marcutudor79/embedded-intrusion-system-ETTI-pr2/Docs/PINOUT.jpeg

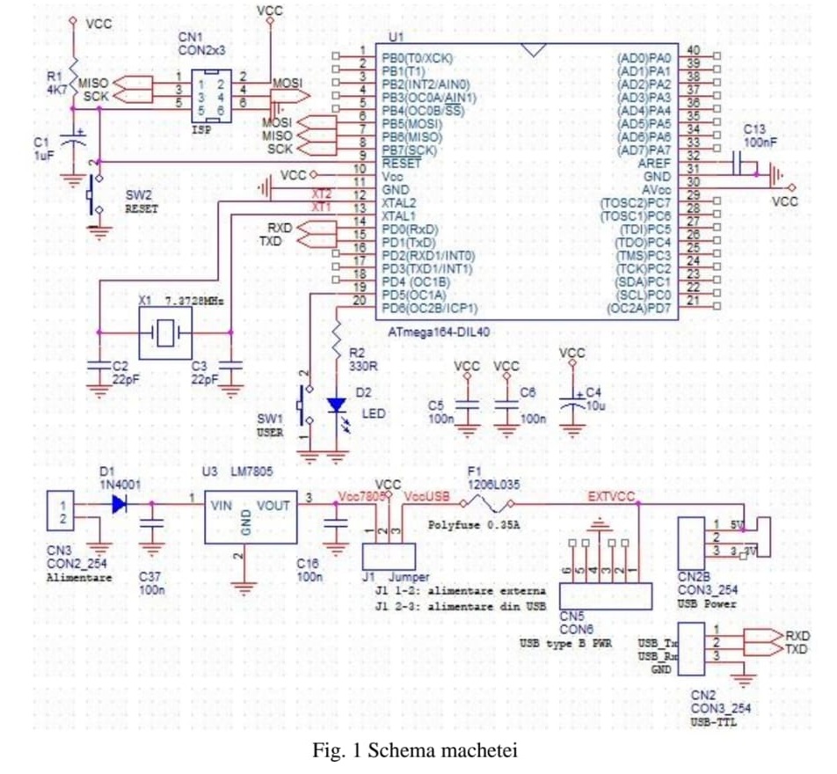
Docs/PINOUT.jpeg
