marcutudor79/embedded-intrusion-system-ETTI-pr2/Docs/Pictures/WhatsApp Image 2023-03-14 at 20.57.14.jpg

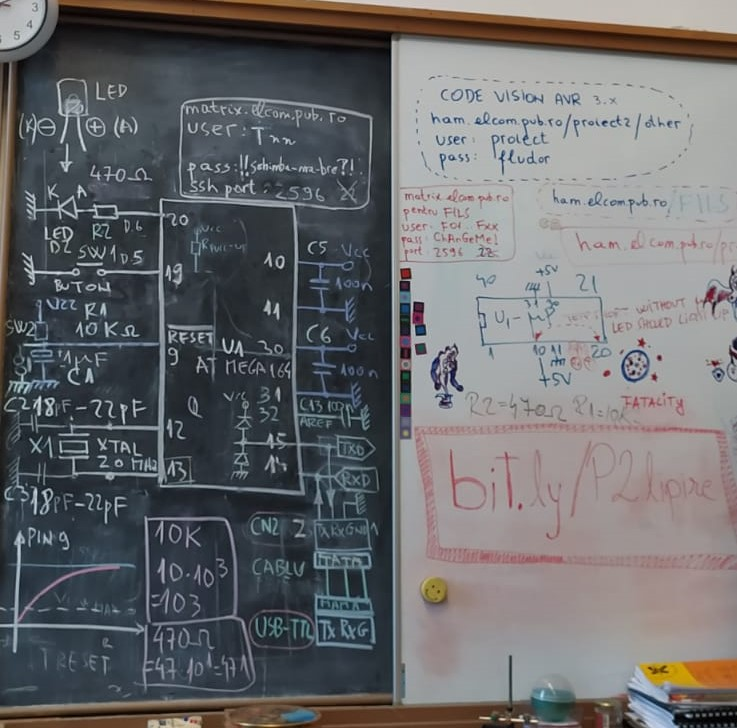
Docs/Pictures/WhatsApp Image 2023-03-14 at 20.57.14.jpg
