marcutudor79/embedded-intrusion-system-ETTI-pr2/Docs/Ordinea recomandata a lipirii pieselor pe placa P2.pdf

Proiect2

## Ordinea recomandata a lipirii pieselor pe placa etti

Se lipesc piese doar pe fateta cu silkscreen (stratul scris cu alb).

Lipim piesele de inaltime redusa mai intai si apoi pe cele de inaltime mai mare.

Pentru componentele SMD se aplica putin fludor pe cele 2 pad-uri, ulterior se prinde cu o penseta si se lipeste la un capat, pe urma la celalalt.

Informatii suplimentare pe site-ul ham (http://ham.elcom.pub.ro/proiect2/doc.htm) (aici (http://ham.elcom.pub.ro/proiect2/solder.htm) si aici). (https://www.youtube.com/watch?v=oqV2xU1fee8)

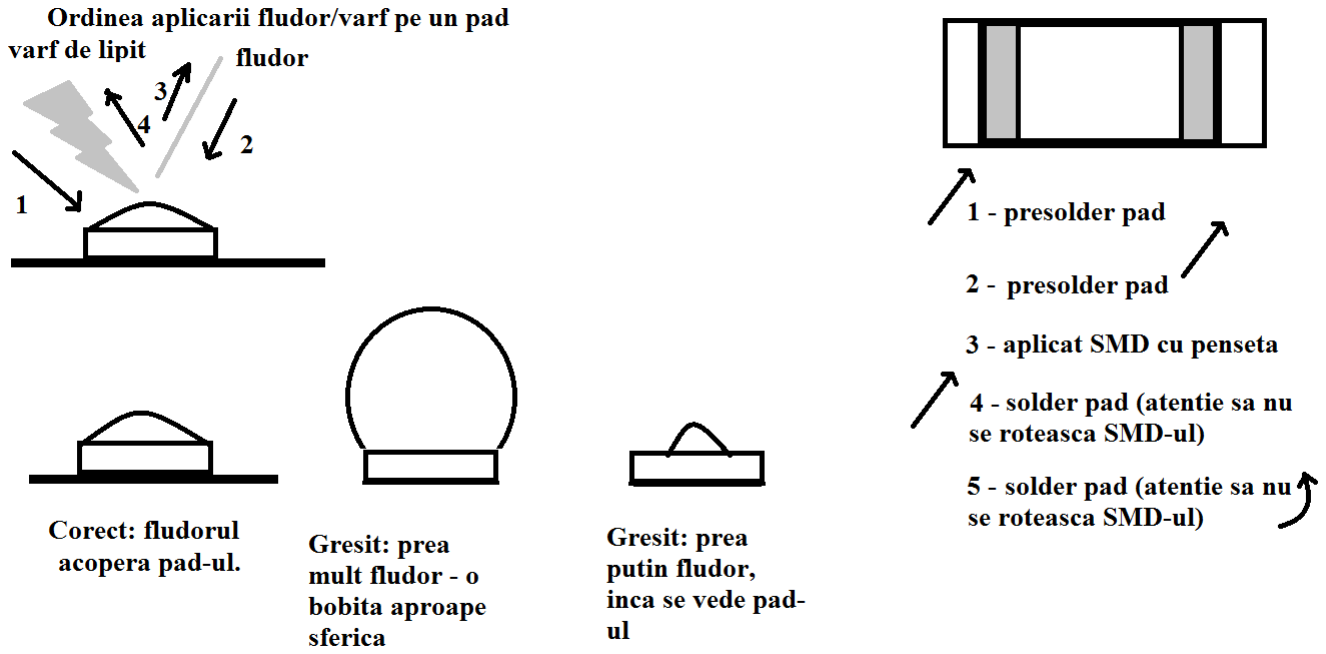
[picture p9: figure]
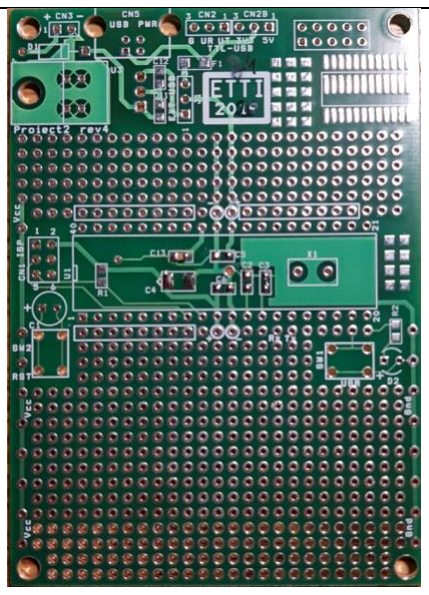
[picture p10: figure]

Incepem din coltul stanga sus. Ordinea recomandata de lipire

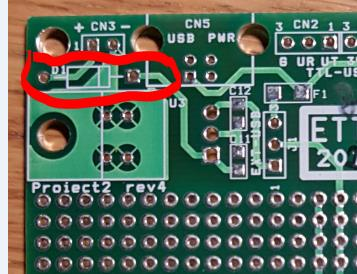
[picture p11: figure]

Dioda D1

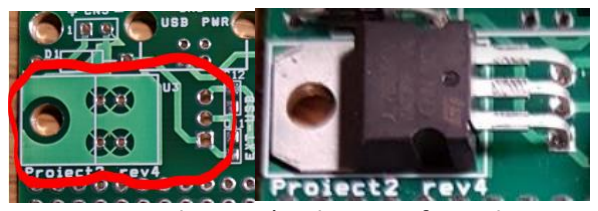
[picture p12: figure]

U3 integratul 7805 (trebuie sa fie indoite terminalele a.i. sa stea pe cablaj si la nevoie sa poata trece surucul de fixare prin integrat si placa)

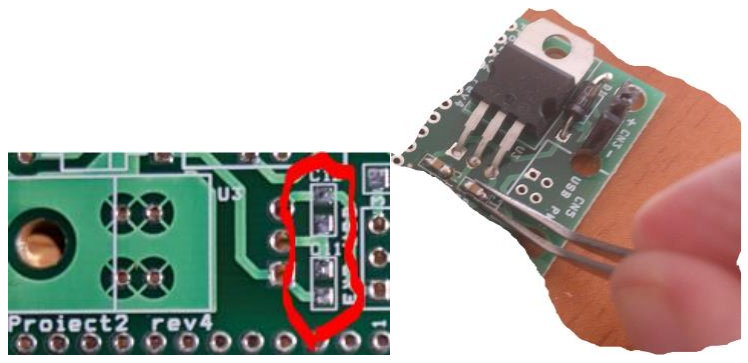
[picture p13: figure]

C12, C11 – 100nF SMD. Acestea trebuie lipite in plan. Daca nu tineti cu penseta bine (pe axa mare SMD-ul) acesta tinde sa se roteasca in sus cand il lipiti la un capat.

CN3 – 1x2pini tata

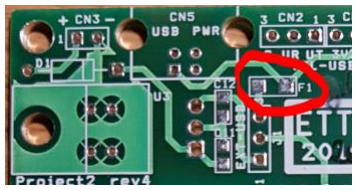
[picture p14: figure]

F1 – aplicati putin solder pe pad-uri.
pentru ca nu consuma mult placile se poate folosi un o bucata de terminal ca scurt in loc de siguranta fuzibila (puteti sa taiati o bucata din terminalul componentei LED sau electrolitic)

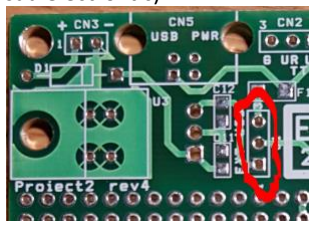
[picture p15: figure]
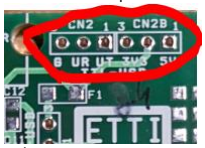
[picture p16: figure]

Cn2/CN2B – 1 x6pini mama apoi J1 – 1x3 pini tata .
Jumperul se pune pe pozitia 1,2 pt alimentare din CN3,sau 2-3 pentru alimentare din CN2/CN2B. Daca nu lucrati in laborator, ci alimentati prin USB de la computer, utilizati 2-3.

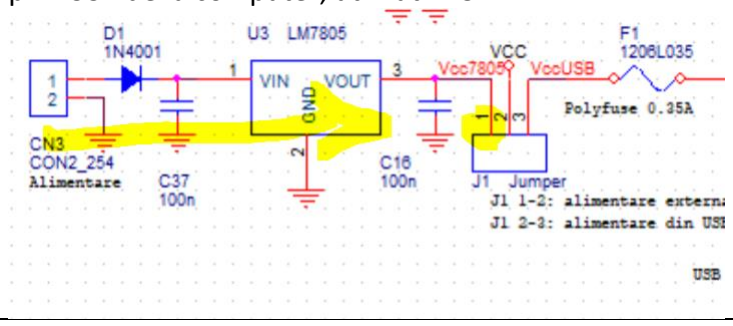
[picture p17: figure]

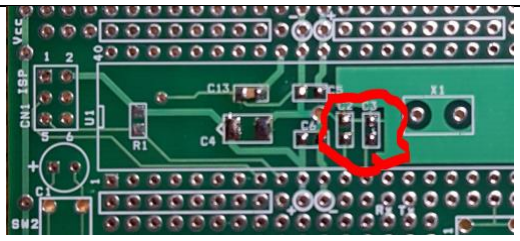
[picture p18: figure]

C2,C3 – 18pF SMD

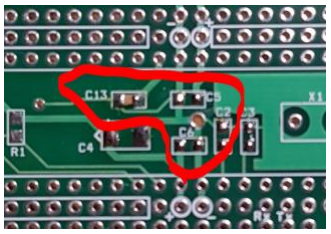
[picture p19: figure]

C5,C6,C13 – 100nF SMD

La C4 nu se lipeste nimic. Idem CN1 ISP.

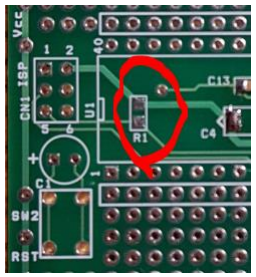
[picture p20: figure]

R1 – 10K Ohm SMD (inscris: 103)

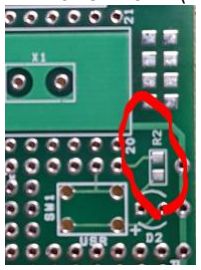
[picture p21: figure]

R2 – 470 Ohm SMD (inscris: 471)

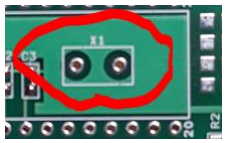
[picture p22: figure]

Cuart THT 20MHz pe X1

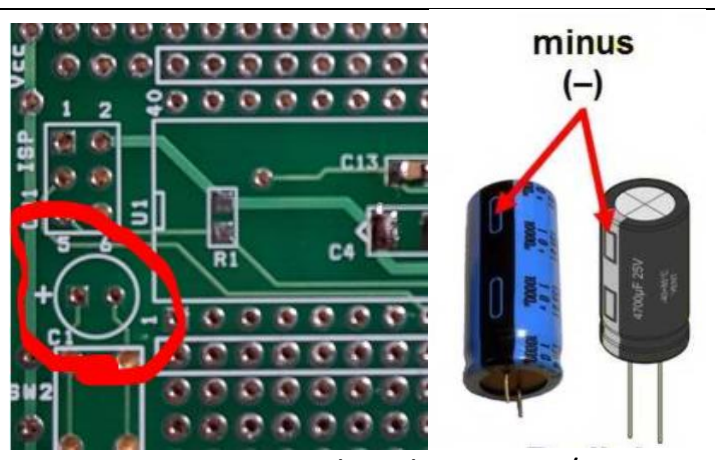
[picture p23: figure]

C1 – 1uF THT, atentie la polarizarea +/-.Minus este marcat cu o band a pe laterala cilindrului.

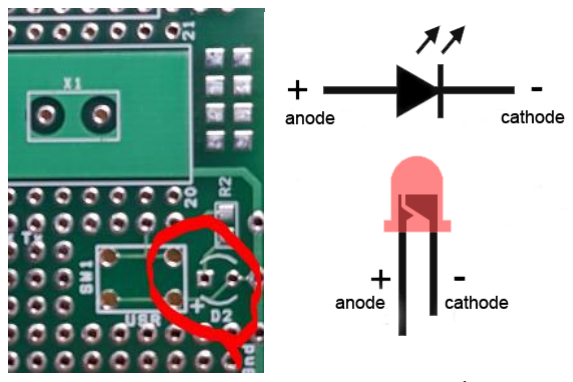
[picture p24: figure]

D2 – LED – atentie la polarizarea +/-

SW1, SW2.

Verificare functionare. Apoi montare soclu microcontroller.

Se verifica functionarea placii alimentând:
- In B210/A226, prin CN3 de la o sursa de laborator cu tensiunea continua in gama 7V-10V.
- Remote, prin CN2/ CN2B, alimentand placa din computer prin portul USB.

Se masoara cu voltmetrul ca intre pinii alimentare/masa (oricare din perechile 10-11 respectiv 30-31) avem aproximativ 5V (4.8-5.2V maxim). Daca se depaseste in jos/sus aceasta valoare verificati lipiturile, si daca nu remarcati probleme contactati profesorul. Nu montati soclul pana nu aveti in jur de 5V la ucontroller.

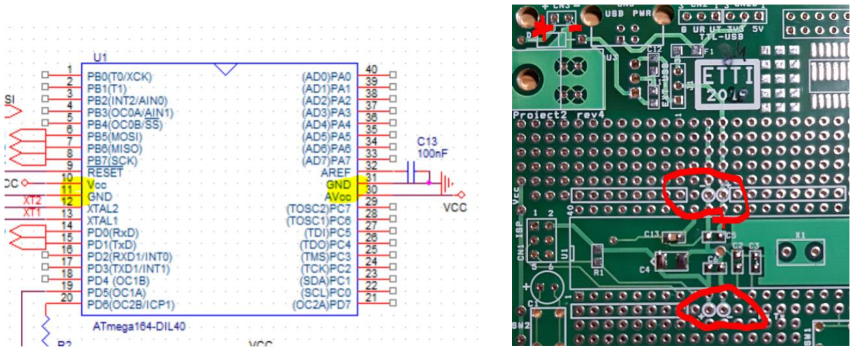
[picture p25: figure]

Doar dupa aceasta verificare se monteaza soclul/se monteaza microcontrollerul. Altfel riscati sa il stricati.
