marcutudor79/embedded-intrusion-system-ETTI-pr2/Schematic/intrusion-system-schematic.pdf

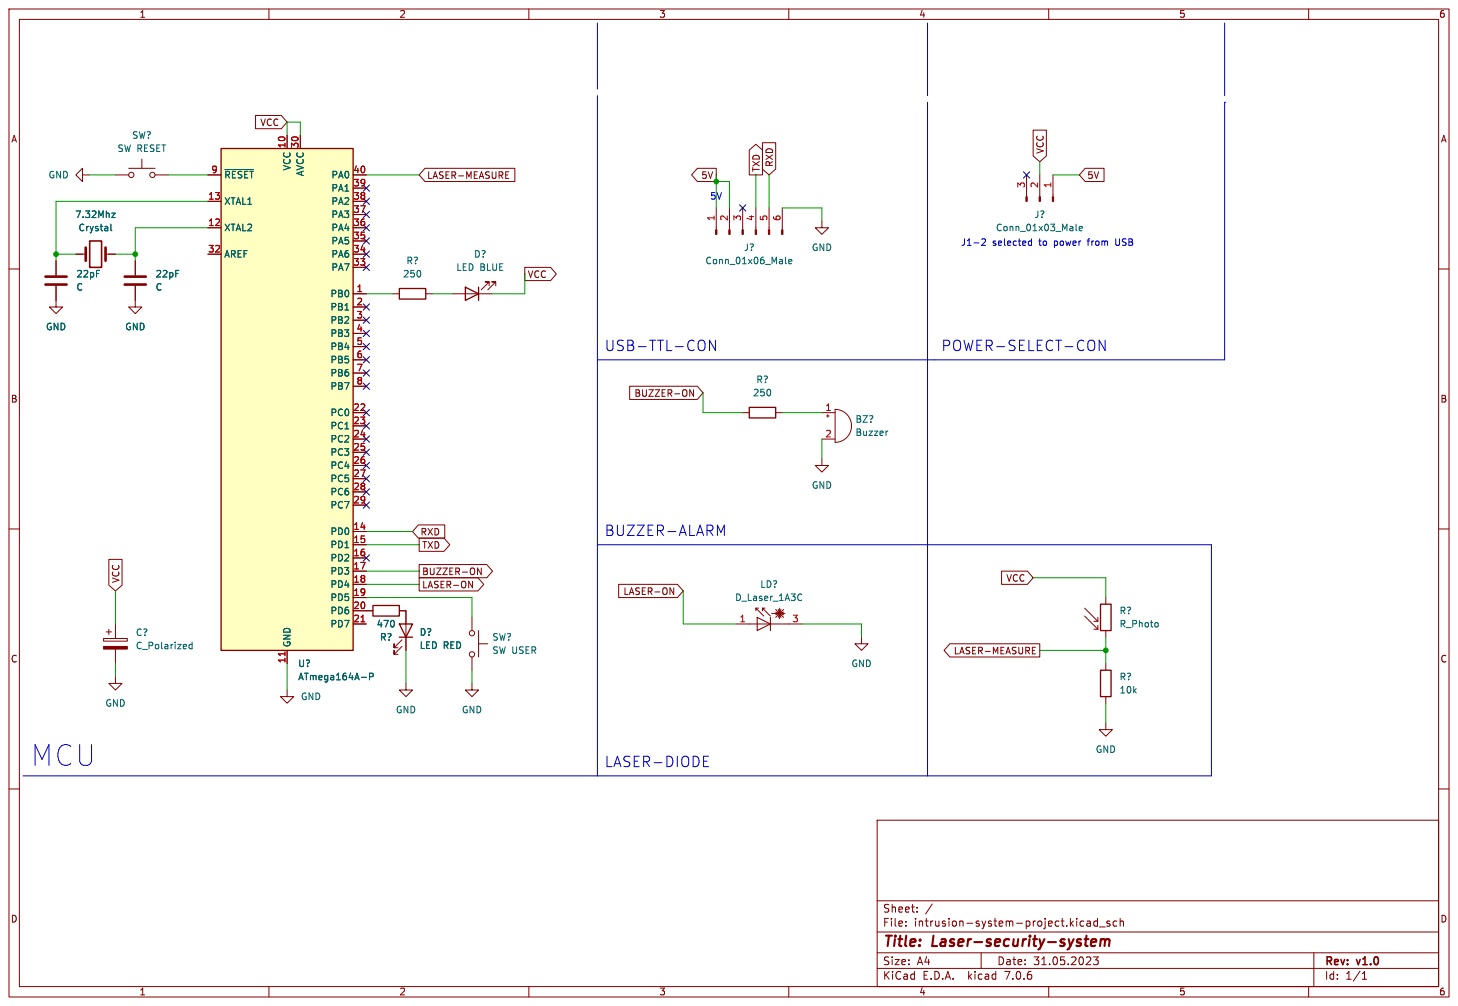
[picture p46: page 1]

LASER-ON

File: intrusion-system-project.kicad_sch Sheet: / D?

Id: 1/1 Title: Laser-security-system
