marcutudor79/embedded-intrusion-system-ETTI-pr2/Schematic/intrusion-system-project.kicad_sch

## KiCad design Schematic/intrusion-system-project.kicad_sch (2024-03-16)

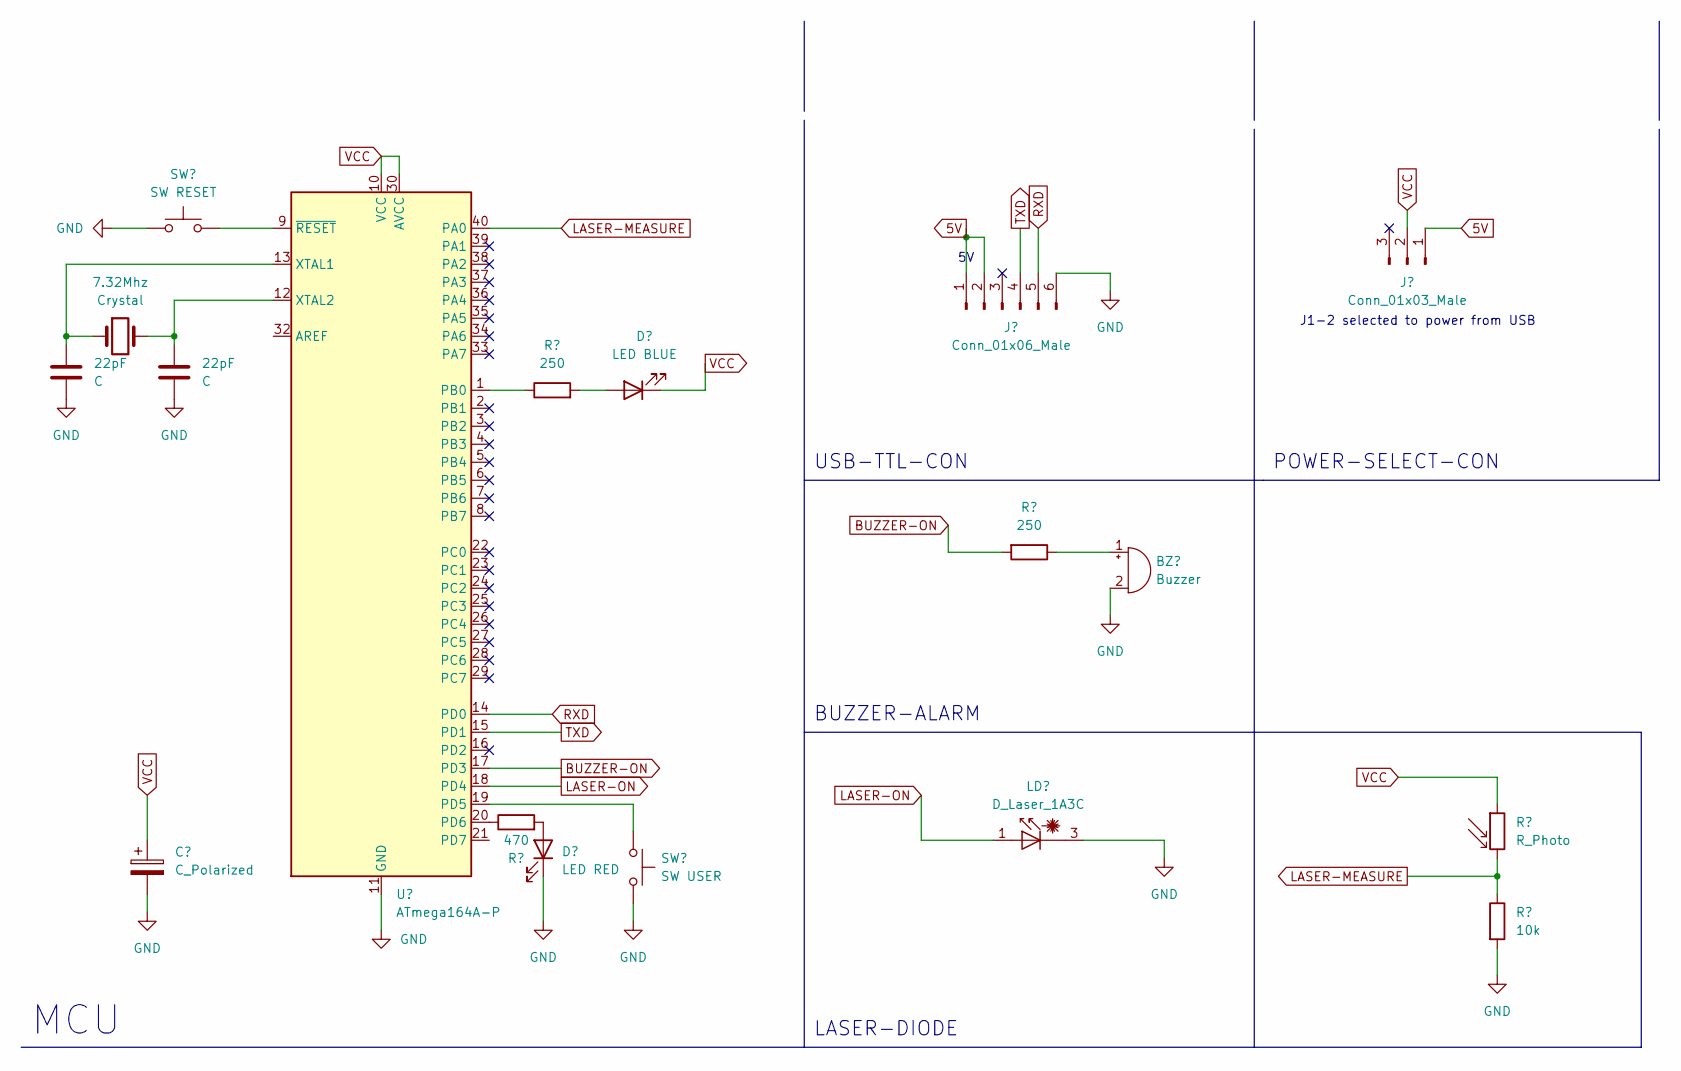
[picture p47: schematic intrusion-system-project.kicad_sch]

Parts:
7.32Mhz: Crystal
22pF: C

Connections:
unnamed: 7.32Mhz.1, 7.32Mhz.2, 22pF.1

Notes on the sheet:
BUZZER-ALARM
LASER-DIODE
MCU
J1-2 selected to power from USB
POWER-SELECT-CON
USB-TTL-CON
