marcutudor79/embedded-intrusion-system-ETTI-pr2/(commit log)

2023-05-13 adc works
    [firmware.cfg]
2024-03-16 Refactor file structure
    [firmware.cfg, intrusion-system-project.kicad_sch, schema_electrica.kicad_pcb, test.cfg]
